plan-zero/automatic-farm/architecture/Bootloader update procedure.jpg

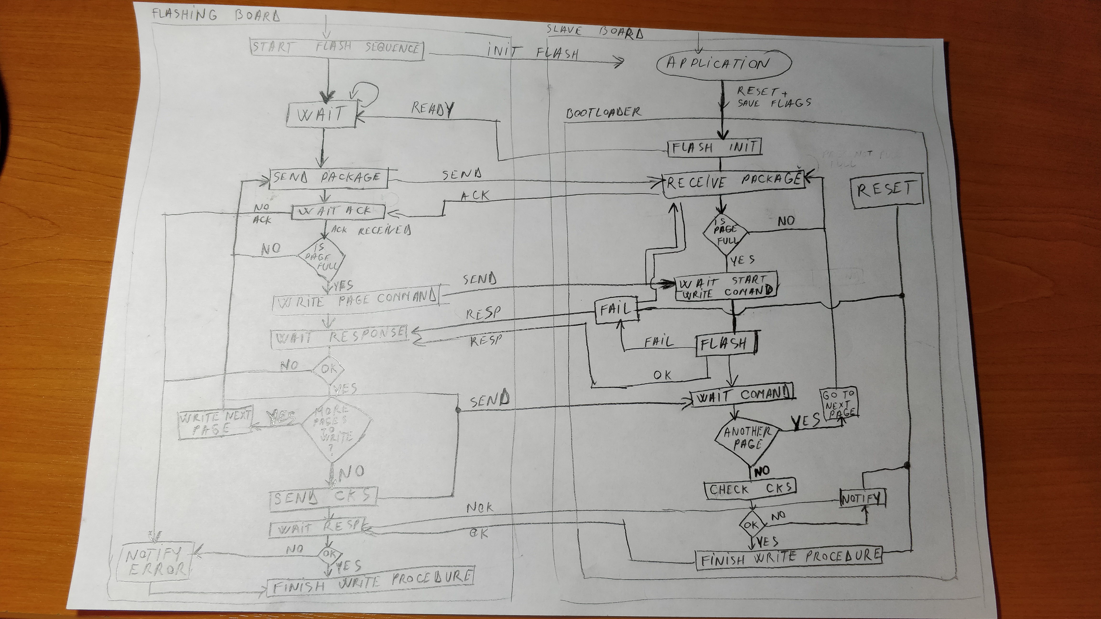
architecture/Bootloader update procedure.jpg
