plan-zero/automatic-farm/architecture/High level architecture.jpg

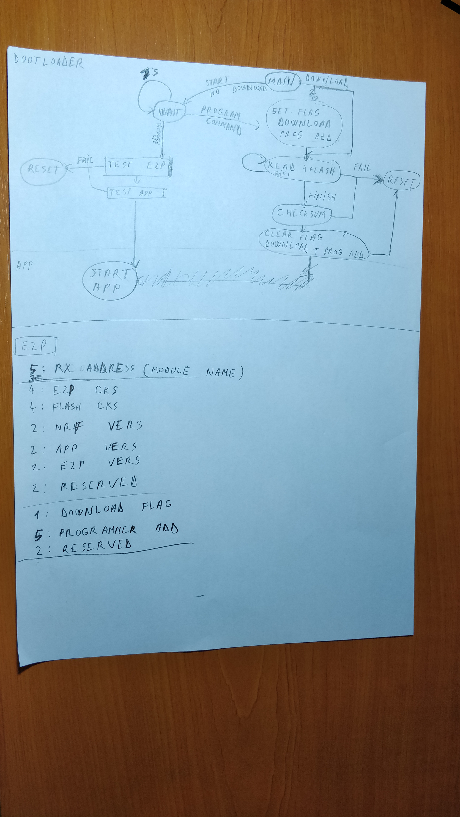
architecture/High level architecture.jpg
