plan-zero/automatic-farm/hardware/v2/BOM_v2.csv

ID | Name | Designator | Footprint | Quantity | Manufacturer Part | Manufacturer | Supplier | Supplier Part | LCSC Assembly
1 | 22pF | C1,C2 | C0603 | 2 | CL10C220JB8NNNC | SAMSUNG | LCSC | C1653 | Yes
2 | 3.9nH | L1 | L0402 | 1 | SDCL1005C3N9STDF | Sunlord | LCSC | C14033 | Yes
3 | 22K | R2 | R0603 | 1 | 0603WAF2202T5E | UniOhm | LCSC | C31850 | Yes
4 | 10nF | C7,C19,C20 | C0402 | 3 | CL05B103KB5NNNC | SAMSUNG | LCSC | C15195 | Yes
5 | 2.4nH | L4,L5 | L0402 | 2 | SDCL1005C2N4STDF | Sunlord | LCSC | C22727 | Yes
6 | Female header 2.54-1*14P | H1,H2 | HDR-TH_14P-P2.54-V | 2 | Female header 2.54-1*14P | BOOMELE | LCSC | C52711
7 | 1K | R5,R6 | R0402 | 2 | 0402WGF1001TCE | UniOhm | LCSC | C11702 | Yes
8 | 4.7uF | C12,C13 | CAP-SMD_L3.5-W2.8 | 2 | CA45-B-16V-4.7uF-K | Shenzhen Zhenhua XinYun Elec | LCSC | C140403 | Yes
9 | 1nF | C6 | C0402 | 1 | 0402B102K500NT | FH | LCSC | C1523 | Yes
10 | 16MHz | X2 | OSC-SMD_4P-L3.2-W2.5-BL | 1 | X322516MLB4SI | YXC | LCSC | C13738 | Yes
11 | 33nF | C5 | C0402 | 1 | 0402F333M500NT | FH | LCSC | C1585 | Yes
12 | RFX2401C | U3 | QFN-16_3X3X05P | 1 | RFX2401C | SKYWORKS | LCSC | C19213 | Yes
13 | U.FL-R-SMT(10) | RF1 | ANT-SMD_UFL-R-SMT | 1 | U.FL-R-SMT(10) | Hirose | LCSC | C434808
14 | 1uF | C10 | C0402 | 1 | CL05A105KA5NQNC | SAMSUNG | LCSC | C52923 | Yes
15 | 1pF | C9 | C0402 | 1 | 0402CG1R0C500NT | FH | LCSC | C1550 | Yes
16 | 4.7pF | C3 | C0402 | 1 | 0402CG4R7C500NT | FH | LCSC | C1569 | Yes
17 | 0.3pF | C18 | C0603 | 1 | CL10C0R3CB8NNNC | SAMSUNG | LCSC | C170140 | Yes
18 | 8.2nH | L3 | L0402 | 1 | SDCL1005C8N2JTDF | Sunlord | LCSC | C16208 | Yes
19 | 2.4GHz | U2 | QFN-20_L4.0-W4.0-P0.50-BL-EP | 1 | NRF24L01P-R | NORDIC | LCSC | C8791 | Yes
20 | 1.5pF | C8,C14,C15,C16,C17 | C0603 | 5 | 0603CG1R5C500NT | FH | LCSC | C1639 | Yes
21 | 220pF | C11 | C0402 | 1 | 0402B221K500NT | FH | LCSC | C1530 | Yes
22 | 20K | R4 | R0402 | 1 | 0402WGF2002TCE | UniOhm | LCSC | C25765 | Yes
23 | ATMEGA328P-AU | U1 | TQFP-32_L7.0-W7.0-P0.80-LS9.0-BL | 1 | ATMEGA328P-AU | MICROCHIP | LCSC | C14877 | Yes
24 | 2.2nF | C4 | C0402 | 1 | 0402B222K500NT | FH | LCSC | C1531 | Yes
25 | 2.7nH | L6 | L0402 | 1 | SDCL1005C2N7STDF | Sunlord | LCSC | C27123 | Yes
