plan-zero/automatic-farm/(threads)

Thread 13 (2020-02-19):

Test communication between v2 and v1 boards

andreimestereaga, 2020-02-19:

andreimestereaga, 2020-03-26:
The communication between Gateway (based on V1) and V2 board is working without big issues. I'm closing the issue.

Closed 2020-03-26.

Thread 21 (2020-03-02):

Test timer's hw macros

andreimestereaga, 2020-03-02:
The goal is to test all macros that are present in timer_hw.h file in order to check that the target registers are set accordingly. Currently this test is made for atmega16
As reference, please use the ATmega16 datasheet (timer/counter 0,1,2 section): http://ww1.microchip.com/downloads/en/devicedoc/doc2466.pdf

The branch name where the testing environment is already created: **add_timer_driver** (please commit on this or branch from this)
