plan-zero/automatic-farm/hardware/Schematic_AutomaticFarm-motherboard_REVD.pdf

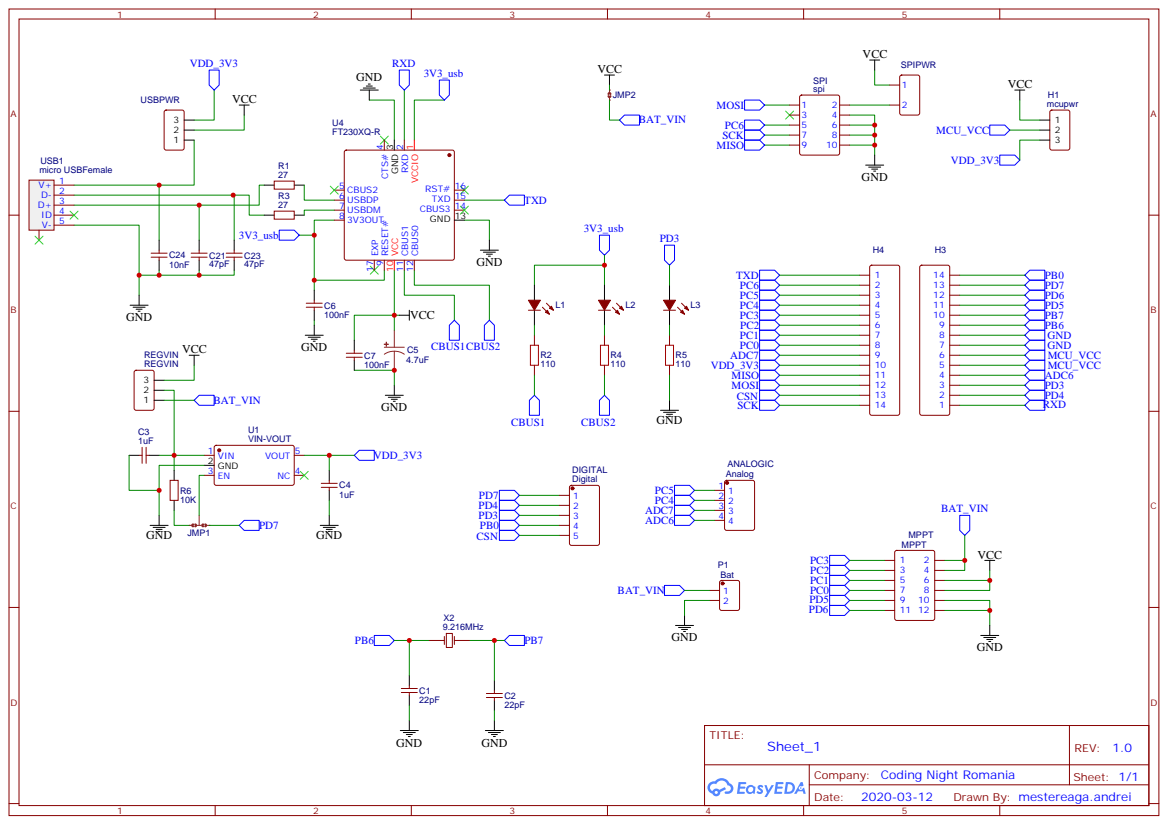
[picture p3: page 1]

Company: Coding Night Romania

Drawn By: mestereaga.andrei
