plan-zero/automatic-farm/hardware/Schematic_AutomationFarm-mainboard_REVA.pdf

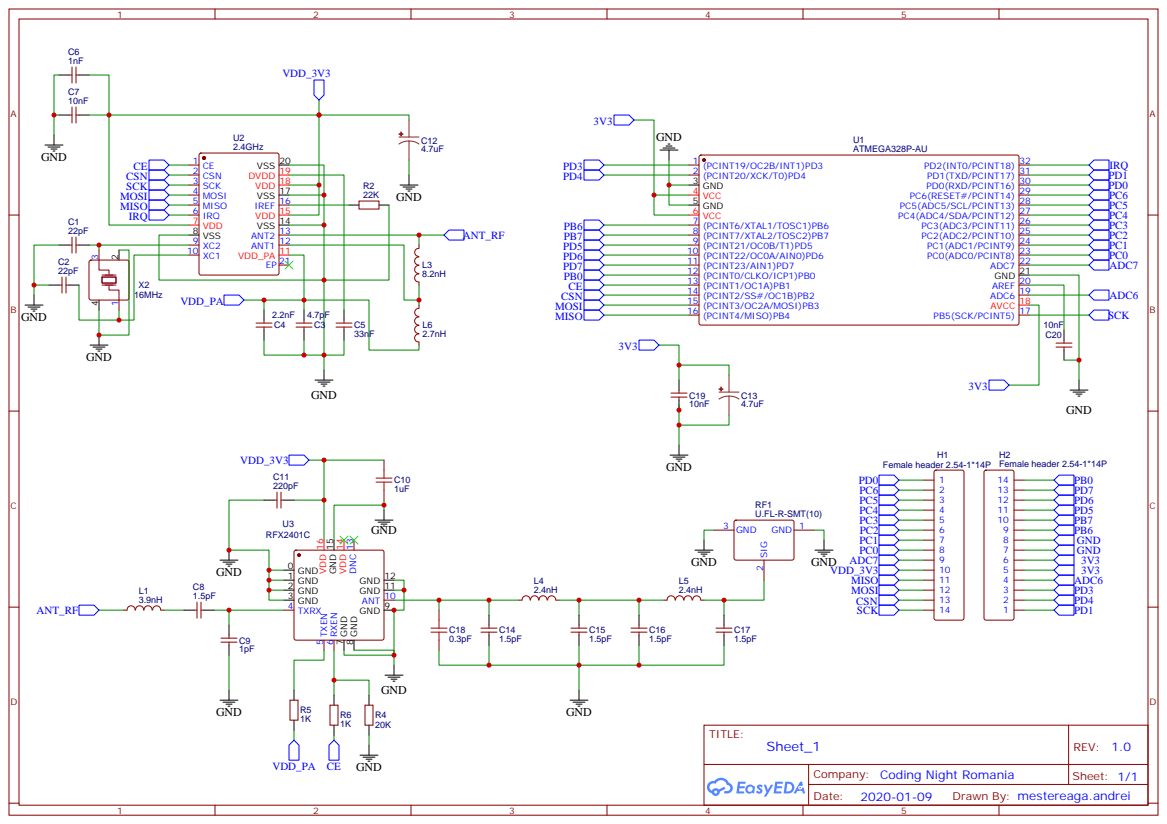
[picture p4: page 1]

Company: Coding Night Romania

Drawn By: mestereaga.andrei
