plan-zero/automatic-farm/hardware/Schematic_AutomationFarm-powerModule_REVA.pdf

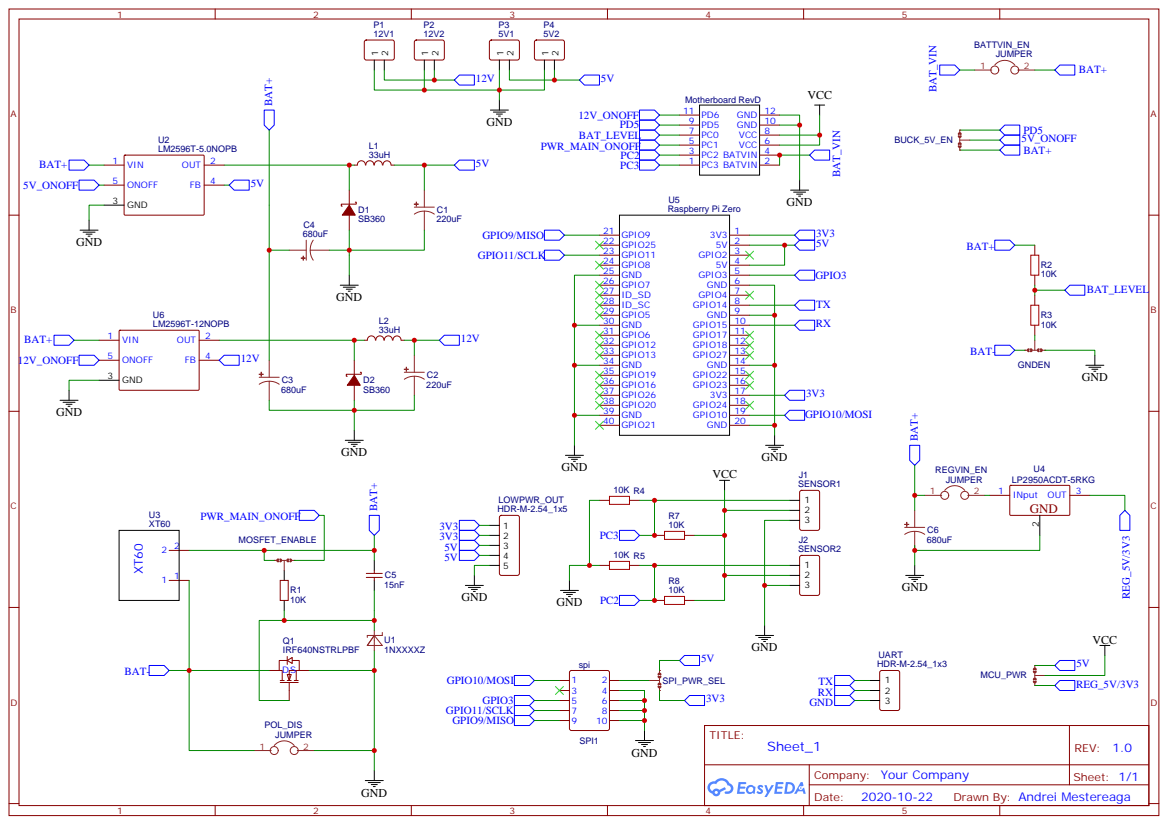
[picture p5: page 1]

Drawn By: Andrei Mestereaga
