plan-zero/automatic-farm/(list of files, drawings)

Other design files:
hardware/v1/v1.dch
hardware/v1/v1.dip
