plan-zero/automatic-farm/nrf24leaf/nrfLibrary/leaf_nrf2401/main.c

#include <avr/io.h>
#include <stdlib.h>

#define F_CPU 8000000UL
#include <util/delay.h>
#include "uart.h"

#include "nrf24Radio.h"

#define uartPrintHex(x) (x > 9 ? uart_sendByte('A' + (x - 10 ) ) : uart_sendByte('0' + x))
#define uartNewLine() /*
		*/ uart_sendByte(10); /*
		*/ uart_sendByte(13)

void uart_printString(char *string, char crlf){
	char *idx = &string[0];

	while(idx != NULL && *idx != '\0'){
		uart_sendByte(*idx);
		idx++;
	}
	if(crlf)
		uartNewLine();
}

void uart_printRegister(unsigned char reg){
	uart_sendByte('0');
	uart_sendByte('x');
	unsigned char n1 = reg >> 4;
	unsigned char n2 = reg & 0x0F;
	uartPrintHex(n1);
	uartPrintHex(n2);
	uart_sendByte(0x20);
	
}

void printRadioInfo(radio_registers regs)
{ 
	uart_printString("CONFIG register: ", 1);
	uart_printRegister(regs.config);
	uartNewLine();
	uart_printString("EN_AA register: ", 1);
	uart_printRegister(regs.en_aa);
	uartNewLine();
	uart_printString("EN_RXADDR register: ", 1);
	uart_printRegister(regs.en_rxaddr);
	uartNewLine();
	uart_printString("SETUP_AW register: ", 1);
	uart_printRegister(regs.setup_aw);
	uartNewLine();
	uart_printString("SETUP_RETR register: ", 1);
	uart_printRegister(regs.setup_retr);
	uartNewLine();
	uart_printString("RF_CH register: ", 1);
	uart_printRegister(regs.rf_ch);
	uartNewLine();
	uart_printString("RF_SETUP register: ", 1);
	uart_printRegister(regs.rf_setup);
	uartNewLine();
	uart_printString("STATUS register: ", 1);
	uart_printRegister(regs.status);
	uartNewLine();
	uart_printString("OBSERVE TX register: ", 1);
	uart_printRegister(regs.observed_tx);
	uartNewLine();
	uart_printString("PIPE 0 address: ", 1);
	uart_printRegister(regs.rx_addr_p0_0);
	uart_printRegister(regs.rx_addr_p0_1);
	uart_printRegister(regs.rx_addr_p0_2);
	uart_printRegister(regs.rx_addr_p0_3);
	uart_printRegister(regs.rx_addr_p0_4);
	uartNewLine();
	uart_printString("PIPE 1 address: ", 1);
	uart_printRegister(regs.rx_addr_p1_0);
	uart_printRegister(regs.rx_addr_p1_1);
	uart_printRegister(regs.rx_addr_p1_2);
	uart_printRegister(regs.rx_addr_p1_3);
	uart_printRegister(regs.rx_addr_p1_4);
	uartNewLine();
	uart_printString("PIPE 2 address: ", 1);
	uart_printRegister(regs.rx_addr_p2);
	uartNewLine();
	uart_printString("PIPE 3 address: ", 1);
	uart_printRegister(regs.rx_addr_p3);
	uartNewLine();
	uart_printString("PIPE 4 address: ", 1);
	uart_printRegister(regs.rx_addr_p4);
	uartNewLine();
	uart_printString("PIPE 5 address: ", 1);
	uart_printRegister(regs.rx_addr_p5);
	uartNewLine();
	uart_printString("TX_ADDR address: ", 1);
	uart_printRegister(regs.tx_addr_0);
	uart_printRegister(regs.tx_addr_1);
	uart_printRegister(regs.tx_addr_2);
	uart_printRegister(regs.tx_addr_3);
	uart_printRegister(regs.tx_addr_4);
	uartNewLine();
	uart_printString("FIFO STATUS: ", 1);
	uart_printRegister(regs.fifo_status);
	uartNewLine();
	uart_printString("DYNPD: ", 1);
	uart_printRegister(regs.dynpd);
	uartNewLine();
	uart_printString("FEATURE: ", 1);
	uart_printRegister(regs.feature);
}

void tx_handler(radio_tx_status tx_status) {
	uart_printString("Radio tx handler", 1);
	if(RADIO_TX_OK == tx_status) {
		uart_printString("TX received ack",1);
	}
	else
		uart_printString("TX not received ack",1);
}

int main(){

	
	uart_init(BAUD9600);
	_delay_ms(500);
	
	uart_printString("_______________________________", 1);
	uart_printString("Radio Initialization", 1);
	radio_config cfg = { RADIO_ADDRESS_5BYTES, 
						 RADIO_RETRANSMIT_WAIT_3000US, 
						 RADIO_RETRANSMIT_15, 
						 CHANNEL_112,
						 RADIO_2MBIT,
						 RADIO_CRC2_ENABLED,
						 RADIO_COUNT_WAVE_DISABLED,
						 RADIO_HIGHEST_0DBM,
						 RADIO_DYNAMIC_PAYLOAD_DISABLED,
						 RADIO_ACK_PAYLOAD_DISABLED,
						 RADIO_DYNAMIC_ACK_DISABLED,
						 RADIO_APPLICATION };
	nrfRadio_Init(cfg);
	
	uint8_t pipe0_address[5] = { 0xE0, 0xE0, 0xE0, 0xE2, 0xA2 };
	pipe_config pipe_cfg = {	RADIO_PIPE1,
								pipe0_address,
								10,
								RADIO_PIPE_RX_ENABLED,
								RADIO_PIPE_AA_DISABLED,
								RADIO_PIPE_DYNAMIC_PYALOAD_DISABLED
							};
	nrfRadio_PipeConfig(pipe_cfg);
	
	uart_printString("Read radio information", 1);
	radio_registers regs = {0}; //init the register
	nrfRadio_GetInfo(&regs);
	printRadioInfo(regs);
	
	//uart_printString("TX done", 1);
	
	nrfRadio_SetTxCallback(tx_handler);
	nrfRadio_PowerUp();
	nrfRadio_TransmitMode();
	uint8_t payload[5] = {1,2,3,4,5};
	uint8_t tx_address[5] =  {0x1,0x2,0x3,0x4,0x5};
	nrfRadio_LoadMessages(payload, 5);
	nrfRadio_Transmit(tx_address, RADIO_RETURN_ON_TX);
	uart_printString("Done tx", 1);
	
	
	while(1){
		nrfRadio_Main();
	}


}
