plan-zero/automatic-farm/python_application/gateway.py

# Copyright (C) 2020 Coding Night Romania
# 
# This file is part of automatic-farm.
# 
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
class GatewayExceptionInit(Exception):
    pass
def throwException(value):
    if value == False:
        raise GatewayExceptionInit()

class ChildState(Enum):
    UNASSIGNED = 1,
    PAIRING = 2,
    PAIRED = 3,
    ERROR = 4

class addressState(Enum):
    UNASSIGNED = 1,
    ASSIGNED = 2

radio_cfg = {
    "pipe0" : "AAAAA",
    "pipe1" : "00AAA",
    "pipe2" : "10AAA",
    "pipe3" : "20AAA",
    "pipe4" : "30AAA",
    "pipe5" : "40AAA"
}

# no : pipe, rx_address, tx_address
radio_child_cfg = {
    "leaf_1" : [ChildState.UNASSIGNED, "pipe1", radio_cfg["pipe1"], "", 0],
    "leaf_2" : [ChildState.UNASSIGNED, "pipe2", radio_cfg["pipe2"], "", 0],
    "leaf_3" : [ChildState.UNASSIGNED, "pipe3", radio_cfg["pipe3"], "", 0],
    "leaf_4" : [ChildState.UNASSIGNED, "pipe4", radio_cfg["pipe4"], "", 0],
    "leaf_5" : [ChildState.UNASSIGNED, "pipe5", radio_cfg["pipe5"], "", 0]
}

pairing_request_count = 0
pairing_request_data = {}

base_addr = "AAA"
start_addr = '1'
dhcp_address = {}
def generate_address():
    global dhcp_address,base_addr,start_addr
    while start_addr <= '~':
        dhcp_address["0" + start_addr + base_addr] = addressState.UNASSIGNED
        start_addr = chr(ord(start_addr) + 1)
    #print(dhcp_address)
def get_new_address():
    global base_addr
    address_assigned = 0
    for address, state in dhcp_address.items():
        if state == addressState.UNASSIGNED:
            address_assigned = 1
            new_addr = address
            dhcp_address[address] = addressState.ASSIGNED
            break
    if address_assigned == 0:
        new_addr = "INVALID"
        print("All addresses are assigned!")
    return new_addr

def broadcast_pairing_msg_check(data):
    global pairing_request_data, pairing_request_count
    #extract the address
    if len(data) >= 6 and "<RX_DATA:B" in data:
        addr = re.findall(r"<RX_DATA:[A-Za-z0-9]+>", data)
        if len(addr) and addr[0] != "":
            addr[0] = re.sub(r"<RX_DATA:B",'',addr[0])
            tx_address = re.sub(r">",'',addr[0])
            print("Extact tx:" + tx_address)
            if not tx_address in pairing_request_data.values():
                print("Add request:" + tx_address)
                pairing_request_data[pairing_request_count] = tx_address
                pairing_request_count += 1

def ack_msg_check(data):
    if "<RX_DATA:A>" in data and "<RX_PIPE:" in data:
        res = re.findall(r"<RX_PIPE:[0-9]+>", data)
        for entry in res:
            pipe_no = re.sub(r"<RX_PIPE:0", '', entry)
            pipe_no = re.sub(r">",'',pipe_no)
            print("pipe ack:" + pipe_no)
            #print(radio_child_cfg["leaf_" + str(pipe_no)][0])
            if radio_child_cfg["leaf_" + str(pipe_no)][0] == ChildState.PAIRED:
                #save the utc
                radio_child_cfg["leaf_" + str(pipe_no)][4] = int(datetime.now(tz=pytz.utc).timestamp())
            else:
                print("Warning: TODO add error handler here")

def join_network_msg_check(data):
    if "<RX_DATA:J" in data and "<RX_PIPE:" in data:
        #take the sender's address
        res = re.search('<RX_DATA:J(.+?)>', data)
        if res:
            tx_address = res.group(1)[:5]
        else:
            return
        res = re.search('<RX_PIPE:0(.+?)>', data)
        if res:
            pipe_no = res.group(1)
        else:
            return
        print("Join requested by " + tx_address + " on pipe " + pipe_no)
        res = NRF24.cmds["set_tx_addr"](tx_address, 0)
        res = NRF24.cmds["set_tx_mode"](0)
        res = NRF24.cmds["send_data"]("P" + str(radio_child_cfg["leaf_" + str(pipe_no)][2]) + tx_address + "000OKJOIN", 0.0001)
        res = NRF24.cmds["set_rx_mode"](0)
def serial_rec_cb(data):
    print("data:" + str(data))
    broadcast_pairing_msg_check(data)
    ack_msg_check(data)
    join_network_msg_check(data)


def init():
    global pairing_request_count
    try:
        #reset module
        res = NRF24.cmds["reset"](2)
        throwException(res)
        #set broadcast
        res = NRF24.cmds["set_rx_addr"](0,radio_cfg["pipe0"],NRF24.CMD_DEF_TIMEOUT)
        throwException(res)
        #set other pipes address
        res = NRF24.cmds["set_rx_addr"](1,radio_cfg["pipe1"],NRF24.CMD_DEF_TIMEOUT)
        throwException(res)
        res = NRF24.cmds["set_rx_addr"](2,radio_cfg["pipe2"],NRF24.CMD_DEF_TIMEOUT)
        throwException(res)
        res = NRF24.cmds["set_rx_addr"](3,radio_cfg["pipe3"],NRF24.CMD_DEF_TIMEOUT)
        throwException(res)
        res = NRF24.cmds["set_rx_addr"](4,radio_cfg["pipe4"],NRF24.CMD_DEF_TIMEOUT)
        throwException(res)
        res = NRF24.cmds["set_rx_addr"](5,radio_cfg["pipe5"],NRF24.CMD_DEF_TIMEOUT)
        throwException(res)
        res = NRF24.cmds["set_rx_mode"](NRF24.CMD_DEF_TIMEOUT)
        throwException(res)
        #register serial callback
        Serial.registerSerialCallback(serial_rec_cb)
        pairing_request_count = 0
        #generate all dhcp addresses
        generate_address()
        return 0
    except Exception as e:
        print(str(e))
        exc_type, exc_obj, exc_tb = sys.exc_info()
        fname = os.path.split(exc_tb.tb_frame.f_code.co_filename)[1]
        print(exc_type, fname, exc_tb.tb_lineno)
        return -1
onetime=0
def pairing_procedure(rx_address, tx_address, slave_tx_address):
    try:
        global onetime
        if onetime == 1:
            return
        onetime = 1
        salve_new_tx = slave_tx_address
        res = NRF24.cmds["set_tx_addr"](tx_address, 0)
        res = NRF24.cmds["set_tx_mode"](0)
        res = NRF24.cmds["send_data"]("P" + rx_address + tx_address + "0001", 0.0001)
        #switch back to rx
        res = NRF24.cmds["set_rx_mode"](0)
        res = NRF24.cmds["read_data"](3)
        if not tx_address + rx_address + "000OK1" in res:
            raise Exception("The slave refused the connection")
        #go back in tx mode
        res = NRF24.cmds["set_tx_addr"](tx_address, 0.1)
        res = NRF24.cmds["set_tx_mode"](0.1)
        #start the pairing
        res = NRF24.cmds["send_data"]("P" + rx_address + tx_address + "0002R", 1)
        res = NRF24.cmds["send_data"]("P" + rx_address + tx_address + "0002P" + salve_new_tx, 0.1)
        if not rx_address + "000OK2" in res:
            raise Exception("Slave refused the pairing!")
        res = NRF24.cmds["set_tx_addr"](salve_new_tx,0.1)
        res = NRF24.cmds["send_data"]("P" + rx_address + salve_new_tx + "0003C", 0.5)
        res = NRF24.cmds["send_data"]("P" + rx_address + salve_new_tx + "0003D", 0.1)
        if not rx_address + "000OK3" in res:
            raise Exception("Connection test failed!")
        res = NRF24.cmds["set_rx_mode"](0.1)
        print("Successfully connected with " + salve_new_tx)
        return 1
        
    except Exception as e:
        print(str(e))
        exc_type, exc_obj, exc_tb = sys.exc_info()
        fname = os.path.split(exc_tb.tb_frame.f_code.co_filename)[1]
        print(exc_type, fname, exc_tb.tb_lineno)
        return -1

def manage_pairing():
    global radio_child_cfg,pairing_request_count,pairing_request_data
    while pairing_request_count:
        pairing_request_count -= 1
        empty_slot = 0
        for leaf, value in radio_child_cfg.items():
            if value[0] == ChildState.UNASSIGNED:
                print("Add child to the following slot: " + leaf)
                empty_slot = 1
                #child_address = get_new_address()
                #if child_address == "INVALID":
                #    print("Can't configure child")
                #    return
                value[0] = ChildState.PAIRING
                print("data " + pairing_request_data[pairing_request_count])
                #configure with the same address
                if pairing_procedure(value[2], pairing_request_data[pairing_request_count], pairing_request_data[pairing_request_count]) == 1:
                    value[0] = ChildState.PAIRED
                    value[3] = pairing_request_data[pairing_request_count]
                else:
                    value[0] = ChildState.UNASSIGNED
                pairing_request_data[pairing_request_count] = ""
                break
        if empty_slot == 0:
            print("No more slots available")
        
def manage_connections():
    global radio_child_cfg
    for leaf, value in radio_child_cfg.items():
        if value[0] == ChildState.PAIRED and value[4] != 0:
            last_online = int(datetime.now(tz=pytz.utc).timestamp()) - value[4]
            if last_online > 30: #if the leaf doesn't respond within 15 seconds
                value[0] = ChildState.ERROR
                print("Leaf:" + str(leaf) + " connection lost for 30 seconds")
        elif value[0] == ChildState.ERROR:
            last_online = int(datetime.now(tz=pytz.utc).timestamp()) - value[4]
            if last_online > 45: #if the leaf dosn't recover within 30 seconds
                print("Leaf:" + str(leaf) + " connection lost for 45 seconds, connection reset")
                value[0] = ChildState.UNASSIGNED
                value[3] = ""
                value[4] = 0

def main():
    print("Gateway v1.0.0")
    print("Gateway starting...")
    init_done = 0
    if 0 == init():
        init_done = 1
    while(init_done):
        Serial.readSerialData()
        manage_pairing()
        manage_connections()
        #time.sleep(0.00)


if __name__ == "__main__":
    main()
