plan-zero/automatic-farm/software/application/Communication/radio_link.c

/**
 * Copyright (C) 2020 Coding Night Romania
 * 
 * This file is part of automatic-farm.
 * 
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
 * You should have received a copy of the GNU General Public License
 * along with automatic-farm.  If not, see <http://www.gnu.org/licenses/>.
 */

#include "radio_link.h"
#include "stdlib.h"
#include "string.h"

#include "nrf24Radio.h"
#include "nrf24Radio_API.h"
#include <util/delay.h>
#include "network_common.h"
#include "e2p.h"
#include "uart.h"
#include "system-timer.h"
#include "Communication.h"
#include "Scheduler.h"

#define STATE_COUNT_3S      300
#define STATE_COUNT_2S      200
#define STATE_COUNT_1S      100
#define STATE_COUNT_500MS   50
#define STATE_COUNT_100MS   10


typedef enum{
    link_none,
    link_establising,
    link_established,
    link_lost,
    link_error,
}link_status_t;

#define MAX_FAILED_ACK 5

typedef struct{
    uint8_t radio_link_status;
    uint8_t radio_tx_pipe_address[RADIO_MAX_ADDRESS];
    uint8_t radio_rx_pipe_address[RADIO_MAX_ADDRESS];
    radio_pipe pipe;
    uint8_t failed_ack;
}radio_link_t;


#define MAX_CMD 3
message_packet_t *_cmds[MAX_CMD];
uint8_t cmd_idx = 0;

uint16_t min_latency = 0xFFFF;
uint8_t selected_tx[RADIO_MAX_ADDRESS];

#define MAX_MASTER_COUNT 3
uint8_t tx_address_idx = 0;
uint8_t *tx_address_latency[3];
uint8_t join_network = 0;

radio_link_t root = {link_none, {0,0,0,0,0}, {0,0,0,0,0}, RADIO_PIPE1};

#define MAX_CHILD 2
radio_link_t child[MAX_CHILD] = 
{
    {link_none, {0,0,0,0,0}, {0,0,0,0,0}, RADIO_PIPE2},
    {link_none, {0,0,0,0,0}, {0,0,0,0,0}, RADIO_PIPE3}
};
uint8_t child_count = 0;


voidFunctionTypeVoid pairing()
{
    //do the pairing request
}

uint8_t * radio_link_get_root_tx()
{
    return &root.radio_tx_pipe_address[0];
}

inline void _add_child(uint8_t *tx_address, uint8_t *rx_address)
{
    if(child_count < MAX_CHILD)
    {
        memcpy(child[child_count].radio_tx_pipe_address, tx_address, RADIO_MAX_ADDRESS);
        memcpy(child[child_count].radio_rx_pipe_address, rx_address, RADIO_MAX_ADDRESS);
    }
    __nrfRadio_PowerDown();
    pipe_config child_pipe = 
	{
		child[child_count].pipe,
		child[child_count].radio_rx_pipe_address,
		RADIO_MAX_ADDRESS,
		RADIO_PIPE_RX_ENABLED,
		RADIO_PIPE_AA_ENABLED,
		RADIO_PIPE_DYNAMIC_PYALOAD_ENABLED
	};
    __nrfRadio_FlushBuffer(RADIO_BOTH_BUFFER);
    __nrfRadio_PipeConfig(child_pipe);
    __nrfRadio_PowerUp();
    __nrfRadio_ListeningMode();
    child[child_count].radio_link_status = link_establising;
}

void radio_link_init()
{
    join_network = 0;
    __nrfRadio_PowerDown();

    //enable broadcast pipe
	pipe_config default_pipe =
	{
		RADIO_PIPE0,
		network_rx_default_address,
		RADIO_MAX_ADDRESS,
		RADIO_PIPE_RX_ENABLED,
		RADIO_PIPE_AA_ENABLED,
		RADIO_PIPE_DYNAMIC_PYALOAD_ENABLED
	};
    uint8_t pipe_def[5] = {0};
    pipe_config rx_root =
    {
        RADIO_PIPE1,
        pipe_def,
        RADIO_MAX_ADDRESS,
		RADIO_PIPE_RX_DISABLED,
		RADIO_PIPE_AA_ENABLED,
		RADIO_PIPE_DYNAMIC_PYALOAD_ENABLED
    };

    for(radio_pipe p = RADIO_PIPE1; p <= RADIO_PIPE5; p++)
    {
        rx_root.pipe = p;
        __nrfRadio_PipeConfig(rx_root);
    }
    
	__nrfRadio_PipeConfig(default_pipe); 
    __nrfRadio_PowerUp();
    __nrfRadio_TransmitMode();
}

uint8_t radio_link_execute(message_packet_t *msg)
{
    if(cmd_idx < MAX_CMD)
    {
        uart_printString("Received execute cmd...",1);
        _cmds[cmd_idx] = msg;
        cmd_idx++;
        return 1;
    }
    return 0;
}

uint8_t radio_link_configure(uint8_t *address_tx, uint8_t *address_rx, uint8_t _address_length)
{
    if(address_rx && _address_length <= RADIO_MAX_ADDRESS)
    {
        memcpy(root.radio_tx_pipe_address, address_tx, _address_length);
        memcpy(root.radio_rx_pipe_address, address_rx, _address_length);
    }
    __nrfRadio_PowerDown();
        //enable broadcast pipe
	pipe_config default_pipe =
	{
		RADIO_PIPE0,
		network_broadcast_address,
		RADIO_MAX_ADDRESS,
		RADIO_PIPE_RX_ENABLED,
		RADIO_PIPE_AA_ENABLED,
		RADIO_PIPE_DYNAMIC_PYALOAD_ENABLED
	};
    __nrfRadio_PipeConfig(default_pipe);
    pipe_config rx_root =
	{
		RADIO_PIPE1,
		root.radio_rx_pipe_address,
		_address_length,
		RADIO_PIPE_RX_ENABLED,
		RADIO_PIPE_AA_ENABLED,
		RADIO_PIPE_DYNAMIC_PYALOAD_ENABLED
	};
    __nrfRadio_PipeConfig(rx_root);
    __nrfRadio_FlushBuffer(RADIO_BOTH_BUFFER);
    __nrfRadio_PowerUp();
    __nrfRadio_ListeningMode();
    root.radio_link_status = link_establising;
    root.pipe = RADIO_PIPE1;
    return 1;
}

uint8_t radio_link_discovery()
{
    //we start to send a broadcast message to see if there is any node available for linking
    
    uint8_t broadcast_msg[15] = {0};
    broadcast_msg[0] = 'B';
    broadcast_msg[14] = '4';
    memcpy(&broadcast_msg[1], &network_rx_default_address[0], 5);
    __nrfRadio_TransmitMode();
    __nrfRadio_LoadMessages(broadcast_msg, 15);
    uint8_t status = __nrfRadio_Transmit(network_broadcast_address, RADIO_WAIT_TX);
    
    if(status == RADIO_TX_OK || status == RADIO_TX_OK_ACK_PYL){
        //the mesage was received, enter in listening and wait instructions on pipe0
        __nrfRadio_ListeningMode();
        uart_printString("Master ACK received!",1);
        
        return 1;
    }
    __nrfRadio_ListeningMode();
    return 0;
}

typedef enum{
    link_init,
    link_discovery,
    link_wait_master,
    link_ping_master,
    link_pairing,
    link_paired,
    link_failed,
}link_state_t;

#include <avr/io.h>

void radio_link_task()
{
    static link_state_t state = link_init;
    static uint16_t state_count = 0;

    state_count++;
    switch (state)
    {
    case link_init:
        {
            radio_link_init();
            state = link_discovery;
            tx_address_idx = 0;
            state_count = 0;
            uart_printString("Enter discovering...",1);
        }
        break;
    case link_discovery:
        if(state_count % STATE_COUNT_1S == 0)
        {
            state_count = 0;
            
            if(radio_link_discovery())
            {
                uart_printString("Enter wait master...",1);
                state = link_wait_master;
                min_latency = 0xFFFF;
                memset(tx_address_latency, 0, RADIO_MAX_ADDRESS);
            }
        }
        break;
    case link_wait_master:
        {
            for(uint8_t idx = 0; idx < cmd_idx; idx++)
            {
                //check just the master answers
                if(_cmds[idx]->msg.data[0] == '1' && tx_address_idx < MAX_MASTER_COUNT)
                {
                    uart_printString("Master request ...",1);
                    //save master address
                    tx_address_latency[tx_address_idx] = malloc(sizeof(uint8_t)* RADIO_MAX_ADDRESS);
                    uint8_t addr[6] = {0};
                    addr[5] = '\0';
                    memcpy(addr, _cmds[idx]->msg.tx_address, 5);
                    uart_printString(addr,1);
                    if(tx_address_latency[tx_address_idx])
                    {
                        memcpy(tx_address_latency[tx_address_idx], _cmds[idx]->msg.tx_address, RADIO_MAX_ADDRESS);
                        tx_address_idx++;
                    }
                }
                //clean cmd message
                memset(_cmds[idx], 0, sizeof(message_packet_t));
                _cmds[idx]->status = msg_status_empty;
            }
            cmd_idx = 0;
            //after 3 seconds
            if(state_count >= STATE_COUNT_3S)
            {
                state_count = 0;
                if(tx_address_idx)
                {
                    uart_printString("Calculate ping for masters ...",1);
                    state = link_ping_master;
                    //change radio to transmit cause we'll start the ping the masters
                    __nrfRadio_TransmitMode();
                }
                else
                {
                    state = link_init;
                }
                
            }
        }
        break;
    case link_ping_master:
        {
            for(uint8_t idx = 0; idx < tx_address_idx; idx++)
            {
                uart_printString("ping master ...",1);
                int32_t delta = 0;
                system_timer_timestamp _start = {0};
                system_timer_timestamp _end = {0};
                uint8_t ping[1] = {'A'};
                uint8_t mean_latency = 0;
                uint8_t tmp[6] = {0};
                tmp[5] = '\0';
                memcpy(tmp, tx_address_latency[idx], 5);
                uart_printString(tmp, 1);
                
                if(tx_address_latency[idx])
                {
                    uint8_t master_ack = 1;
                    for(uint8_t itr = 0; itr < 2; itr++)
                    {
                        uart_printString("Ping test",1);
                        __nrfRadio_LoadMessages(ping, 1);
                        _start =  system_timer_get_timestamp();
                        radio_tx_status ping_status =  __nrfRadio_Transmit(tx_address_latency[idx], RADIO_WAIT_TX);
                        _end = system_timer_get_timestamp();
                        if(RADIO_TX_OK == ping_status)
                        {
                            delta = system_timer_getus(_start,_end);
                            mean_latency += delta;
                        }
                        else
                        {
                            uart_printString("NACK",1);
                            master_ack = 0;
                        }
                    }
                    if(master_ack)
                    {
                        mean_latency = mean_latency / 4;
                        //DBG INFO
                        uint8_t tmp[12] = {0};
                        sprintf(tmp, "%u",mean_latency);
                        tmp[11] = '\0';
                        uart_printString(tmp, 1);
                        /////////////////////////
                        if(mean_latency < min_latency)
                        {
                            uart_printString("save new master..",1);
                            min_latency = mean_latency;
                            memcpy(selected_tx, tx_address_latency[idx], RADIO_MAX_ADDRESS);
                        }
                    }
                }
                //free memory that was allocated for tx latency calculation
                free(tx_address_latency[idx]); 
            }

            //send the request to the master
            message_t msg = {0};
            uint8_t _data[] = {'O','K','1'};
            message_create(START_BYTE_PAIRING,&msg,selected_tx,_data,3);
            __nrfRadio_FlushBuffer(RADIO_BOTH_BUFFER);
            __nrfRadio_LoadMessages(msg.raw, 17);
            radio_tx_status res = __nrfRadio_Transmit(selected_tx, RADIO_WAIT_TX);
            if(RADIO_TX_OK == res)
            {
                __nrfRadio_ListeningMode();
                __nrfRadio_FlushBuffer(RADIO_BOTH_BUFFER);
                state = link_pairing;
                state_count = 0;
            }
            else
            {
                uart_printString("no master ack",1);
                state = link_init;
            }
                
            
        }
        break;
    case link_pairing:
        //TODO: add a timeout to this state, otherwise the procedure will stuck here
        for(uint8_t idx = 0; idx < cmd_idx; idx++)
        {
            uart_printString("execute cmd...",1);
            switch (_cmds[idx]->msg.data[0])
            {
            case '2':
            {
                uart_printString("radio_link execute cmd 2",1);
                //check if this master has the lowest ping rate
                if(0 == memcmp(_cmds[idx]->msg.tx_address, selected_tx, RADIO_MAX_ADDRESS))
                {
                    uart_printString("from selected master",1);
                    //request pair
                    if(_cmds[idx]->msg.data[1] == 'R')
                    {
                        uart_printString("request pair...", 1);
                        message_t msg = {0};
                        uint8_t _data[] = {'O','K','2'};
                        message_create(START_BYTE_PAIRING,&msg,_cmds[idx]->msg.tx_address,_data,3);
                        __nrfRadio_LoadAckPayload(RADIO_PIPE0, msg.raw, 17);
                    }
                    //Configure with the following configuration
                    else if(_cmds[idx]->msg.data[1] == 'P')
                    {
                        uart_printString("configure link...", 1);
                        radio_link_configure(_cmds[idx]->msg.tx_address,
                                            &_cmds[idx]->msg.data[2], 
                                            RADIO_MAX_ADDRESS);
                    }
                }
                else
                {
                    //refuse the pairing, there is another master that is more suitable
                    uint8_t config_ack_msg[8] = {'N','O','K'};
                    memcpy(&config_ack_msg[3], _cmds[idx]->msg.tx_address, RADIO_MAX_ADDRESS);
                    __nrfRadio_LoadAckPayload(RADIO_PIPE0, config_ack_msg, 8);
                }
                break;
            }
            break;
            //check the connection and if this is stable, then the pairing is complete
            case '3':
            {
                if(0 == memcmp(_cmds[idx]->msg.tx_address, selected_tx, RADIO_MAX_ADDRESS))
                {
                    if(_cmds[idx]->msg.data[1] == 'C')
                    {
                        uart_printString("check connection...", 1);
                        message_t msg = {0};
                        uint8_t _data[] = {'O','K','3'};
                        message_create(START_BYTE_PAIRING,&msg,_cmds[idx]->msg.tx_address,_data,3);
                        __nrfRadio_LoadAckPayload(root.pipe, msg.raw, 17);
                    }
                    else if(_cmds[idx]->msg.data[1] == 'D')
                    {
                        memset(tx_address_latency, 0, RADIO_MAX_ADDRESS);
                        min_latency = 0xFFFF;
                        uart_printString("connection established...", 1);
                        state = link_paired;
                        root.radio_link_status = link_established;
                    }
                }
                break;
            }
            default:
                break;
            }
            memset(_cmds[idx], 0, sizeof(message_packet_t));
            _cmds[idx]->status = msg_status_empty;
        }
        cmd_idx = 0;
        break;
    case link_paired:
        //send an ACK msg to parent to make sure that the connection is still working
        for(uint8_t idx = 0; idx < cmd_idx; idx++)
        {
            if(_cmds[idx]->msg.data[0] == '4')
            {
                uart_printString("Child pairing request",1);
                message_t msg = {0};
                msg.type = 'P';
                memcpy(msg.tx_address, root.radio_rx_pipe_address, RADIO_MAX_ADDRESS);
                memcpy(msg.rx_address, _cmds[idx]->msg.tx_address, RADIO_MAX_ADDRESS);
                msg.data[0] = '1';
                __nrfRadio_TransmitMode();
                __nrfRadio_LoadMessages(msg.raw, 15);
                radio_tx_status res = __nrfRadio_Transmit(_cmds[idx]->msg.tx_address, RADIO_WAIT_TX);
                __nrfRadio_ListeningMode();
                if(RADIO_TX_OK == res || RADIO_TX_OK_ACK_PYL == res){
                    uart_printString("msg sent",1);
                }
            }
            else if(memcmp(_cmds[idx]->msg.data,"OK1", 3) == 0)
            {
                uart_printString("Child accepted this master",1);
                message_t msg = {0};
                msg.type = 'P';
                memcpy(msg.tx_address, root.radio_rx_pipe_address, RADIO_MAX_ADDRESS);
                memcpy(msg.rx_address, _cmds[idx]->msg.tx_address, RADIO_MAX_ADDRESS);
                msg.data[0] = '2';
                msg.data[1] = 'R';
                __nrfRadio_TransmitMode();
                __nrfRadio_LoadMessages(msg.raw, 16);
                radio_tx_status res = __nrfRadio_Transmit(_cmds[idx]->msg.tx_address, RADIO_WAIT_TX);
                __nrfRadio_ListeningMode();
                if(RADIO_TX_OK == res || RADIO_TX_OK_ACK_PYL == res){
                    uart_printString("msg sent",1);
                }
                msg.data[1] = 'P';
                memcpy(&msg.data[2], _cmds[idx]->msg.tx_address, RADIO_MAX_ADDRESS);
                //send the pairing msg
                communication_outbox_add(msg, 21, 15);
                uint8_t rx_child_addr[RADIO_MAX_ADDRESS] = {0};
                memcpy(rx_child_addr, network_rx_default_address, RADIO_MAX_ADDRESS);
                rx_child_addr[0] = '0' + (child_count + 1);
                _add_child(_cmds[idx]->msg.tx_address, rx_child_addr);
            }
            else if(memcmp(_cmds[idx]->msg.data,"OK2", 3) == 0)
            {
                uart_printString("Check connection with child",1);
                message_t msg = {0};
                msg.type = 'P';
                memcpy(msg.tx_address, root.radio_rx_pipe_address, RADIO_MAX_ADDRESS);
                memcpy(msg.rx_address, child[child_count].radio_tx_pipe_address, RADIO_MAX_ADDRESS);
                msg.data[0] = '3';
                msg.data[1] = 'C';
                __nrfRadio_TransmitMode();
                __nrfRadio_LoadMessages(msg.raw, 16);
                radio_tx_status res = __nrfRadio_Transmit(child[child_count].radio_tx_pipe_address, RADIO_WAIT_TX);
                __nrfRadio_ListeningMode();
                if(RADIO_TX_OK == res || RADIO_TX_OK_ACK_PYL == res){
                    uart_printString("msg sent",1);
                }
                msg.data[1] = 'D';
                communication_outbox_add(msg, 16, 15);
            }
            else if(memcmp(_cmds[idx]->msg.data,"OK3", 3) == 0)
            {
                uart_printString("Child pair OK",1);
                child[child_count].radio_link_status = link_established;
                child_count++;
            }
            else if(memcmp(_cmds[idx]->msg.data,"OKJOIN", 3) == 0)
            {
                join_network = 1;
            }
            memset(_cmds[idx], 0, sizeof(message_packet_t));
            _cmds[idx]->status = msg_status_empty;
        }
        cmd_idx = 0;
        if(state_count % 1000 == 0)
        {
            if(0 == join_network)
            {
                //send a join network msg
                message_t msg = {0};
                message_create(START_BYTE_JOINNET,&msg, root.radio_tx_pipe_address,root.radio_rx_pipe_address,RADIO_MAX_ADDRESS);
                communication_outbox_add(msg, 19, 0);
            }
            state_count = 0;
            __nrfRadio_TransmitMode();
            uint8_t ack_msg[1] = {'A'};
            __nrfRadio_LoadMessages(ack_msg, 1);
            radio_tx_status status = __nrfRadio_Transmit(root.radio_tx_pipe_address, RADIO_WAIT_TX);
            __nrfRadio_ListeningMode();
            if(RADIO_TX_OK == status)
            {
                //uart_printString("ACK Root: OK",1);
                if(root.failed_ack)
                    root.failed_ack--;
            }
            else
            {
                uart_printString("ACK Root: NOK",1);
                root.failed_ack++;
            }
            if(root.failed_ack >= MAX_FAILED_ACK)
            {
                uart_printString("Connection lost...",1);
                state = link_failed;
            }
        }
        break;
    case link_failed:
        memset(&root, 0, sizeof(radio_link_t));
        __nrfRadio_FlushBuffer(RADIO_BOTH_BUFFER);
        state = link_init;
        break;
    default:
        break;
    }
}
