plan-zero/automatic-farm/software/testing/oneWireDev_testbench/main.c

#include <avr/io.h>
#include "uart.h"

#include "ds18b20.h"
#include <util/delay.h>
#include "stdint.h"
#include "stdio.h"
#include "atmega-adc.h"
#include "lowpower.h"
#include "wdg.h"

int main()
{

    uart_init(UART_115200BAUD, UART_110592MHZ, UART_PARITY_NONE);
    uart_printString("One wire testing", 1);

    char string[20];
    int32_t data = 0;
    uint32_t adc = 0;
    double tmp = 0;

    while(1)
    {
        //sendData(75);
        //adc = adc_read(ADC_PRESCALER_32, ADC_VREF_AVCC, 0);
        //tmp = (adc * 3.3) / 1023.0 * 100.00;
        //adc = (int)tmp;
        if(STATUS_DS18B20_OK != ds18b20_start_conv(0))
        {
            uart_printString("DS18 device busy!",1);
        }
        while(!ds18b20_is_ready());
        
        data = ds18b20_gettemp();
        sprintf(string,"TMP:%ld", data);
        uart_printString(string,1);
        _delay_ms(100);
        
        //go to sleep for 8 sec
        //
        goToSleep(WAKEUP_4S);
        

        

    }
}
