plan-zero/automatic-farm/software/testing/aes_testbench/aes_test.c

#include "stdlib.h"
#include <avr/io.h>
#include <util/delay.h>

#include "aes.h"
#include "uart.h"

uint8_t data[] = {'A', 'N', 'D', 'R', 'E', 'I','A', 'N', 'D', 'R', 'E', 'I','1','2','3','4'};

int main()
{
    DDRB |= 1;
    uart_init(UART_9600BAUD, UART_8MHZ, UART_PARITY_NONE);
    uart_printString("AES test",1);
    uint8_t key[16] = {'1','2','3','4','5','6','7','8','9','1','2','3','4','5','6','7'};
    uint8_t expkey[176] = {0};
    aesKeyExpand(key, expkey);
    for(uint8_t i = 0; i < 16; i++)
        uart_sendByte(data[i]);
    uartNewLine();
    PORTB ^= 1;
    aesCipher(expkey, data);
    for(uint8_t i = 0; i < 16; i++)
        uart_sendByte(data[i]);
    uartNewLine();
    PORTB ^= 1;
    aesInvCipher(expkey, data);
    for(uint8_t i = 0; i < 16; i++)
        uart_sendByte(data[i]);
    uartNewLine();

    uart_printString("Aes done",1);
    PORTB ^= 1;
    
    
    while(1)
    {
        _delay_ms(1000);
    }

    return 0;
}
