plan-zero/automatic-farm/(commit log)

2019-09-13 Fix the replicate cmd-msg bug
    [commands_module.py]
2019-11-07 Add usb driver for programmer and firmware initial version
2019-11-10 Add the correct reading sequence - we have to read all NRF messages, otherwise the RX_FIFO will be blocked and further incoming messages will be dropped
    [main.c]
2019-11-18 Update the python application - fix few reboot issues
    [gsm_module.py, main.py, reboot_module.py]
2019-11-21 Fix atmel studio environment
    [main.c, nrf24Radio.c, nrf24Radio.h]
2019-11-21 Fix compilation errors and implmenet the ACK payload load function in radio library
    [main.c, nrf24Radio.c, nrf24Radio.h]
2019-11-21 Move the uart functions from application to UART lib
2019-11-25 Add cproj files for bootloader, app, radio and uart Atmel projects
2019-11-26 Use __flash directive to fix the pointer casting problem in AVR flash
    [main.c]
2019-11-26 Add bootloader settings and move the ptrs to the 0x2800. Move the nrf24 library to 0x2840 (this is 4KB for code, currently it has 3KB)
2019-11-28 Nrf24update + architecture pictures flip
    [nrf24Radio.h]
2019-11-28 Radio fix incluzion problem
    [nrf24Radio.c]
2019-11-29 Extend the uart driver: Add new baudrates for each supported CPU freq (1MHz - 16 MHz). Add parity feature
2019-11-29 Add updates in UART library - it reports back any RX error
2019-12-02 Remove the space when the uart is priting a HEX char
2019-12-02 Remove the sei call from uart init - this brokes the NRF configuration
2019-12-03 Move the SPI functions to the nrf24 section since these should be in the NRFLIB memory as well
2019-12-06 Fixing code, add data section at 0090 and radio data at 0060
    [main.c, nrf24Radio.c]
2019-12-07 Remove all APIs calls from ISR and replace them with the their body code
    [nrf24Radio.c]
2019-12-10 Add PL2303 driver for win10
2019-12-10 Fix few issues in flashing tool
    [flash-tool.py]
2019-12-10 fix to state machines and responses for flash tool
    [flash-tool.py]
2019-12-12 Add hex ascii support programmer (#3)
    * Add support for HEX-ASCII payloads
    * Fix few issues in ASCII_HEX programmer command; also change uart register print function to skip the 0x leading chars for any hex value
    * Change the format of AVRDUDE read from r (raw) to i (intel)
    [main.c]
2019-12-12 Finish bootloader implementation (#5)
    * moved E2p clear write flag in BOOTLOADER_FLASH_END
    * Add CRC verification
    * Add state BOOTLOADER_WAIT_FLASH_END
    * CRC + RESET + eait after BOOTLOADER_FLASH_ERROR
    * Add first version - unfinished of CRC calculate
    * Add first version of CRC16 tool
    * Add address in CRC output - if this is needed
    [WriteApp.c]
2019-12-14 Change the SPI initialization, when this is done second time then we should't set the MOSI / SCK as input then as output - this was a bad idea (#6)
2019-12-15 Solve the CRC problem - now this is calculated correctly for any application
    [flash-tool.py]
2019-12-16 Some fixes in code to work with flashing tool / programmer
    [flash-tool.py, main.c]
2020-01-07 Nrf shared data new design (#8)
    * Add first version of new NRF design - the shared data is now initialized by APP / bootloader and it is passed to library using a pointer
    * Add depedencies for APP, Bootloader, Programmer so the uart & nrf will be built first
    * Rollback the CRC, we don't have the fill in line with 0xFF
    * We don't fill the line with 0xFF if there are no 16B
    * We use the shared file instead of moving the whole .data section
    * Remove .data section settings from programmer & bootloader
    * Add KEY feature in flashing tool, the key is used to put the application in bootloader
    * Modify the application to accept the key and to enter in bootloader in this case
    *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
2020-01-14 Remove 2x UART speed - this doesn't work well with old quartz, also update UART's baud const values. Change script to use 2 stopbit instead of one (also changed in uart driver)
    [flash-tool.py]
2020-01-25 Redefine UART baud's value with U2X disabled
2020-02-18 Avr cmake support code (#10)
    * Add the first version of CMake config
    * Remove CHACHE arg from cmakelist - this lead to some errors
    * Add top CMakeLists file
    * Simplfy Cmake configuration
    * Add script for toolchain setup
    * GIT:Ignore build & toolchain directories
    * Change project structure, add hardware definition for atmega16: currently just nrf24
    * Add new rule for .lss file
    * Install firmware hex file to assets in software; add assets folder to gitignore; additional clean command for .map file
    * Add spi_hw file for atmega16; also strip down the spi driver
    * Strip down the nrf24 module and move the interrupt / hw functionality to atmega16 hw
    * Simplify and a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
    [WriteApp.c, WriteApp.h, flash-tool.py, main.c]
2020-02-19 Avr cmake support code (#11)
    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
2020-02-22 Update bootloader to use just the drivers; update e2p to add definitions for e2p update/get values; remove GenericLib header since this is obsolete
2020-02-22 Add flash_layout header in flash driver
2020-03-02 Add timer driver (#22)
    * Add timer hw definition and driver - first implementation
    * Add other definitions for timer16
    * Add structures and definition for timer driver
    * Add general deifinition for TIMER macros to select the timer instance using the precompiler
    * Update timer_hw to allow multiple parameters for TIMER8 defines
    * Add some new definitions to timer_hw that are required by the driver
    * Add a first version of timer.c implementation using the timer_hw's macros
    * Add interrupt implementation for timer driver
    * Add testing env for timer / timer_hw modules
    * Add few tests in timer_test module as POC
    * Remove status flag from timer cfg
2020-03-03 Add wdg driver implementation (#25)
2020-03-05 Add hardware projects for v1 (Developed in Diptrace) and v2 (developed in EasyEDA - also included the BOM and Pick&Place files)
    [BOM_v2.csv, PickAndPlace_v2.csv, v1.dch, v1.dip]
2020-03-16 Timer integration with scheduler (#29)
    * first version
    * Few hot fixes for timer module & app
    * Add scheduler testing task for 1ms - used just to measure the task accuracy
    * Add a task simulator - it could be useful at some point
    * Implemented timer
    * Fix timer bug
    * Scheduler add task interface (#27)
    * Modify the scheduler to allow to add tasks at runtime
    * Add scheduler APIs in public header; move testing functions to main application
    * Added custom interval tasks and alarms
    * made the alarm function global
    * Fixed alarm and custom timer
    [Main.c]
2020-03-16 System timer implementation (#30)
    * Add tiny-AES external project as an impoerted static library
    * Add testing bench for AES tiny library
    * Add another fast AES implementation - around 350us encryption/decryption
    * Finish system-timer implementation v1
2020-03-16 Timer test (#31)
    * addings define for timer
    * testing functTimer
2020-03-25 Migrate atmega328p drivers (#32)
    * Add HW layer for atmega328p and make the changes to get a free errors compilation
    * Milestone for a working code - CRC had to be changed to support atmega328p (no backward compatibility now)
    * Change the CRC to be made just for flashed pages, not entire memory - this allow us to have backward compatibility with other devices
    * Replace the magic value with the define parameter; change the APP page size to 192 for atmega328p
    * Fix the checksum failed problem - the wdg timeout on MCU was increased at 1s - to have enough time to erase all pages
    [WriteApp.c, flash-tool.py, timer_test.c]
2020-03-26 Fix timer interrupts m328p (#33)
    * Hotfix for timer / interrupts problem on atmega328p
    * Change the interrupt_hw so now you can enable / disable timer ISRs from there; add a new macro in timer to get the number of timer's CHs; change applicaiton to include uart / wdg modules
    * Simplify the timer configuration structure
    [Main.c]
2020-03-28 Application ota support (#34)
    * Reorganize the application code, enable watchdog
    * Add changes to support the nrf24 OTA in the application; fix some problems in flashing tool regarding to the application size; define the download 0xAA value in e2p; Add new sw components for OTA and Communication handler
    * Remove dbg messages
    * Fix the CMake boot key string configuration; fix the problem in CRC when an extra page is added; remove unused comma from python script
    [Communication.c, Communication.h, Main.c, flash-tool.py]
2020-05-08 Star v1 implementation (#35)
    * Remove the calibration form system-timer; Add ping command in programmer
    * Add first implementation for mesh comm, it is just progress - it's not functional yet
    * Add network definitions; modify the pairing procedure
    * Add fw_table changes
    * Add progress for communication implementation; add messages definition; add task to process all incoming messages
    * Add more functionality to pairing procedure -the master is selected based on latency value
    * Add the tx address in each ACK response
    * Add ACK checking after the communication has been established
    * Add nrf24 script on python side which represents the master part
    * Add nrf24 FLUSH bu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
2020-11-13 Add files via upload
    Add HW schematic for mainboard
2020-11-13 Add files via upload
    Add HW schematic for motherboard
2021-02-07 Add support for 11059200HZ. Add testing env for one wire setup
2021-02-07 Still fixing 11.059Mhz table
    [Main.c, main.c]
2021-02-07 Add code for ds18b20 sensor
2021-02-07 Add ADC driver code
2021-02-08 Make temp sensor integer only
2021-02-09 Add low power module (#36)
2021-02-09 Gateway implementation (#37)
    * Add programmer following functions:reset, set RX pipe
    * Add gateway first implementation
    * Add dhcp address support for gateway
    * No more dhcp server, the addresses are assigned by cmake at build time
    * Add join network procedure
    * Extend the messages functionality to simplify the code design
    * Stable version with some fixes
    * Simplfy the message structure, the rx / tx are not inverted anymore for receieve messages expecting the ones that are processing by the current device
    [Communication.c, Communication.h, Main.c, flash-tool.py, gateway.py, main.c, messages.c, messages.h]
2021-02-13 Add sleep mode depending on battery level / temperature
2021-02-27 Fix undervoltage / low temp events
    [main.c]
